hboughardain/automatic-wire-cutter/LaTeX/corps/0-page-de-garde.tex

\center
    \newcommand{\HRule}{\rule{\linewidth}{0.5mm}} 
    
    \begin{figure}
       \centering
      
    \end{figure}
    
    \textsc{\Large Computing project}\\[0.5cm] 
	\textsc{\Large PROJ-H402}\\[0.5cm]

    \vspace{1cm}

	\HRule\\[0.4cm]
	{\huge\bfseries\textsc{Rapport de projet}}\\[0.3cm] 
	\HRule\\[1.5cm]

    \begin{minipage}{0.5\textwidth}
		\begin{flushleft}
			\large
			\textit{Auteur}\\
			Haythem \textsc{Boughardain}
        \end{flushleft}
    \end{minipage}
        ~
	\begin{minipage}{0.4\textwidth}
		\begin{flushright}
			\large
			\textit{Superviseurs}\\
			Quentin \textsc{Delhaye}\\
			François \textsc{Quitin}
		\end{flushright}
	\end{minipage}
        
    \vspace{1cm}
	\begin{figure}[h!]
	   \centering
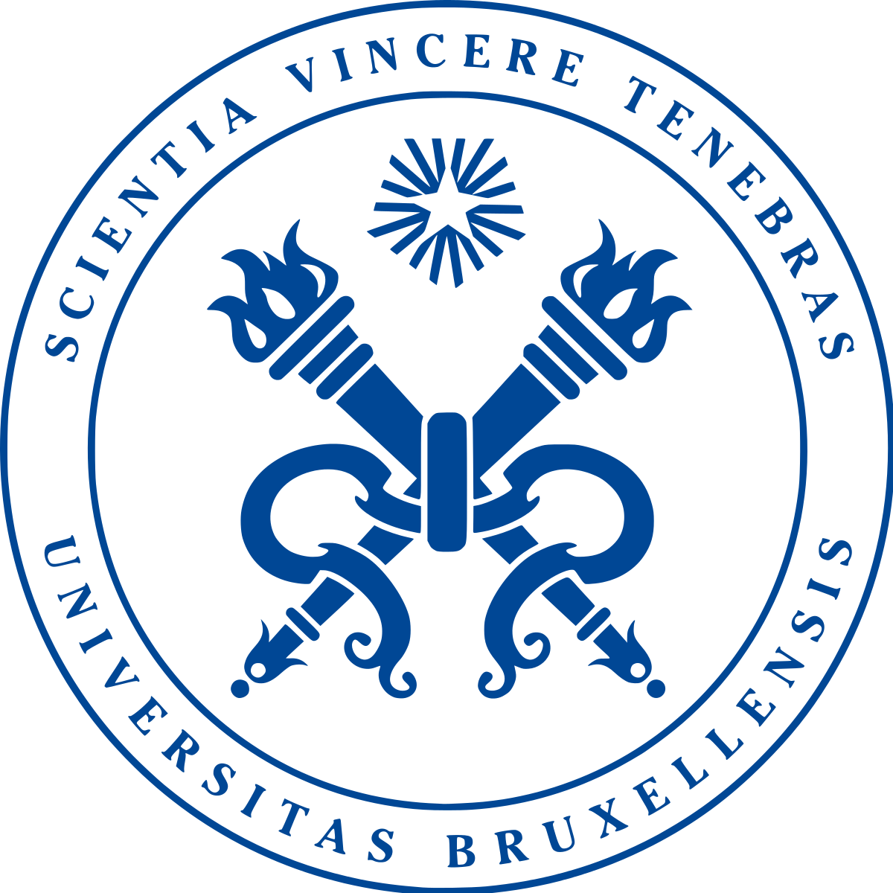
[picture p1: LaTeX/images/logo-ulb.png]
	  
	\end{figure}
    \vspace*{\fill}

	{\large \textsc{Année académique 2021--2022}}
