hboughardain/automatic-wire-cutter/LaTeX/corps/1-intro.tex

Dans le cours de \textsc{Computing project}, il est demandé aux étudiants de choisir un sujet parmi une liste imposée, et de mener à bien le projet qui en découle. Dans le cadre de ce rapport, le projet choisi est celui d'un prototype permettant la coupe automatique de fil électrique, à travers l'utilisation d'un microcontrôleur ainsi que d'un système d'alimentation et de coupe de fil. Ce rapport va ainsi passer sur les choix technologiques qui ont été effectués durant l'année académique, la manière par laquelle le prototype final pourra être dupliqué, comment celui-ci pourra être utilisé, et enfin les améliorations éventuelles qui pourraient lui être apportées.
