hboughardain/automatic-wire-cutter/STL Files/Manivelle.stl

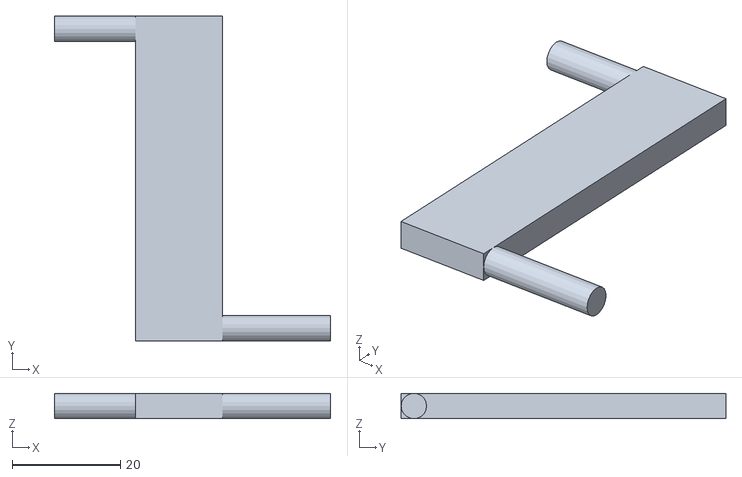
[picture p14: CAD file, 2022-05-17]
STL Files/Manivelle.stl
51.0 x 60.0 x 4.70
