hboughardain/automatic-wire-cutter/STL Files/SupportPince.stl

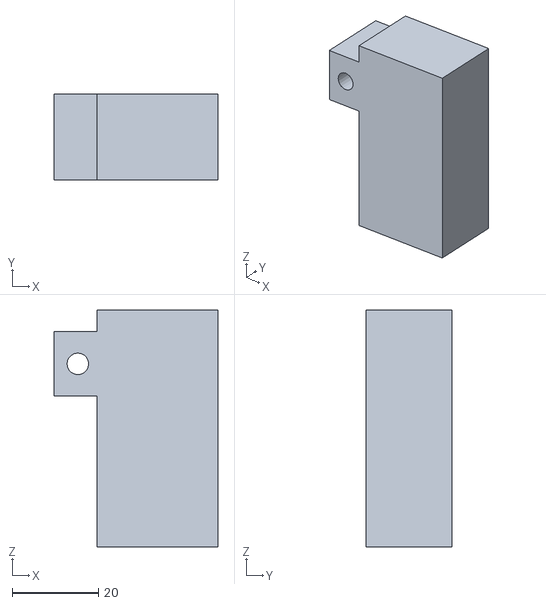
[picture p15: CAD file, 2022-05-17]
STL Files/SupportPince.stl
38.0 x 20.0 x 55.0
