hboughardain/automatic-wire-cutter/STL Files/SupportMoteur.stl

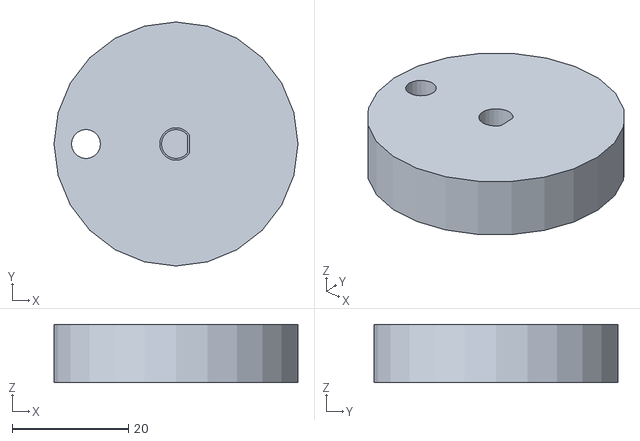
[picture p16: CAD file, 2022-05-17]
STL Files/SupportMoteur.stl
42.0 x 42.0 x 10.0
