hboughardain/automatic-wire-cutter/codegentemp/StepperMotorTimer.h

/*******************************************************************************
* File Name: StepperMotorTimer.h
* Version 2.80
*
*  Description:
*     Contains the function prototypes and constants available to the timer
*     user module.
*
*   Note:
*     None
*
********************************************************************************
* Copyright 2008-2017, Cypress Semiconductor Corporation.  All rights reserved.
* You may use this file only in accordance with the license, terms, conditions,
* disclaimers, and limitations in the end user license agreement accompanying
* the software package with which this file was provided.
********************************************************************************/

#if !defined(CY_TIMER_StepperMotorTimer_H)
#define CY_TIMER_StepperMotorTimer_H

#include "cytypes.h"
#include "cyfitter.h"
#include "CyLib.h" /* For CyEnterCriticalSection() and CyExitCriticalSection() functions */

extern uint8 StepperMotorTimer_initVar;

/* Check to see if required defines such as CY_PSOC5LP are available */
/* They are defined starting with cy_boot v3.0 */
#if !defined (CY_PSOC5LP)
    #error Component Timer_v2_80 requires cy_boot v3.0 or later
#endif /* (CY_ PSOC5LP) */


/**************************************
*           Parameter Defaults
**************************************/

#define StepperMotorTimer_Resolution                 16u
#define StepperMotorTimer_UsingFixedFunction         1u
#define StepperMotorTimer_UsingHWCaptureCounter      0u
#define StepperMotorTimer_SoftwareCaptureMode        0u
#define StepperMotorTimer_SoftwareTriggerMode        0u
#define StepperMotorTimer_UsingHWEnable              0u
#define StepperMotorTimer_EnableTriggerMode          0u
#define StepperMotorTimer_InterruptOnCaptureCount    0u
#define StepperMotorTimer_RunModeUsed                0u
#define StepperMotorTimer_ControlRegRemoved          0u

#if defined(StepperMotorTimer_TimerUDB_sCTRLReg_SyncCtl_ctrlreg__CONTROL_REG)
    #define StepperMotorTimer_UDB_CONTROL_REG_REMOVED            (0u)
#elif  (StepperMotorTimer_UsingFixedFunction)
    #define StepperMotorTimer_UDB_CONTROL_REG_REMOVED            (0u)
#else 
    #define StepperMotorTimer_UDB_CONTROL_REG_REMOVED            (1u)
#endif /* End StepperMotorTimer_TimerUDB_sCTRLReg_SyncCtl_ctrlreg__CONTROL_REG */


/***************************************
*       Type defines
***************************************/


/**************************************************************************
 * Sleep Wakeup Backup structure for Timer Component
 *************************************************************************/
typedef struct
{
    uint8 TimerEnableState;
    #if(!StepperMotorTimer_UsingFixedFunction)

        uint16 TimerUdb;
        uint8 InterruptMaskValue;
        #if (StepperMotorTimer_UsingHWCaptureCounter)
            uint8 TimerCaptureCounter;
        #endif /* variable declarations for backing up non retention registers in CY_UDB_V1 */

        #if (!StepperMotorTimer_UDB_CONTROL_REG_REMOVED)
            uint8 TimerControlRegister;
        #endif /* variable declaration for backing up enable state of the Timer */
    #endif /* define backup variables only for UDB implementation. Fixed function registers are all retention */

}StepperMotorTimer_backupStruct;


/***************************************
*       Function Prototypes
***************************************/

void    StepperMotorTimer_Start(void) ;
void    StepperMotorTimer_Stop(void) ;

void    StepperMotorTimer_SetInterruptMode(uint8 interruptMode) ;
uint8   StepperMotorTimer_ReadStatusRegister(void) ;
/* Deprecated function. Do not use this in future. Retained for backward compatibility */
#define StepperMotorTimer_GetInterruptSource() StepperMotorTimer_ReadStatusRegister()

#if(!StepperMotorTimer_UDB_CONTROL_REG_REMOVED)
    uint8   StepperMotorTimer_ReadControlRegister(void) ;
    void    StepperMotorTimer_WriteControlRegister(uint8 control) ;
#endif /* (!StepperMotorTimer_UDB_CONTROL_REG_REMOVED) */

uint16  StepperMotorTimer_ReadPeriod(void) ;
void    StepperMotorTimer_WritePeriod(uint16 period) ;
uint16  StepperMotorTimer_ReadCounter(void) ;
void    StepperMotorTimer_WriteCounter(uint16 counter) ;
uint16  StepperMotorTimer_ReadCapture(void) ;
void    StepperMotorTimer_SoftwareCapture(void) ;

#if(!StepperMotorTimer_UsingFixedFunction) /* UDB Prototypes */
    #if (StepperMotorTimer_SoftwareCaptureMode)
        void    StepperMotorTimer_SetCaptureMode(uint8 captureMode) ;
    #endif /* (!StepperMotorTimer_UsingFixedFunction) */

    #if (StepperMotorTimer_SoftwareTriggerMode)
        void    StepperMotorTimer_SetTriggerMode(uint8 triggerMode) ;
    #endif /* (StepperMotorTimer_SoftwareTriggerMode) */

    #if (StepperMotorTimer_EnableTriggerMode)
        void    StepperMotorTimer_EnableTrigger(void) ;
        void    StepperMotorTimer_DisableTrigger(void) ;
    #endif /* (StepperMotorTimer_EnableTriggerMode) */


    #if(StepperMotorTimer_InterruptOnCaptureCount)
        void    StepperMotorTimer_SetInterruptCount(uint8 interruptCount) ;
    #endif /* (StepperMotorTimer_InterruptOnCaptureCount) */

    #if (StepperMotorTimer_UsingHWCaptureCounter)
        void    StepperMotorTimer_SetCaptureCount(uint8 captureCount) ;
        uint8   StepperMotorTimer_ReadCaptureCount(void) ;
    #endif /* (StepperMotorTimer_UsingHWCaptureCounter) */

    void StepperMotorTimer_ClearFIFO(void) ;
#endif /* UDB Prototypes */

/* Sleep Retention APIs */
void StepperMotorTimer_Init(void)          ;
void StepperMotorTimer_Enable(void)        ;
void StepperMotorTimer_SaveConfig(void)    ;
void StepperMotorTimer_RestoreConfig(void) ;
void StepperMotorTimer_Sleep(void)         ;
void StepperMotorTimer_Wakeup(void)        ;


/***************************************
*   Enumerated Types and Parameters
***************************************/

/* Enumerated Type B_Timer__CaptureModes, Used in Capture Mode */
#define StepperMotorTimer__B_TIMER__CM_NONE 0
#define StepperMotorTimer__B_TIMER__CM_RISINGEDGE 1
#define StepperMotorTimer__B_TIMER__CM_FALLINGEDGE 2
#define StepperMotorTimer__B_TIMER__CM_EITHEREDGE 3
#define StepperMotorTimer__B_TIMER__CM_SOFTWARE 4



/* Enumerated Type B_Timer__TriggerModes, Used in Trigger Mode */
#define StepperMotorTimer__B_TIMER__TM_NONE 0x00u
#define StepperMotorTimer__B_TIMER__TM_RISINGEDGE 0x04u
#define StepperMotorTimer__B_TIMER__TM_FALLINGEDGE 0x08u
#define StepperMotorTimer__B_TIMER__TM_EITHEREDGE 0x0Cu
#define StepperMotorTimer__B_TIMER__TM_SOFTWARE 0x10u


/***************************************
*    Initialial Parameter Constants
***************************************/

#define StepperMotorTimer_INIT_PERIOD             23999u
#define StepperMotorTimer_INIT_CAPTURE_MODE       ((uint8)((uint8)1u << StepperMotorTimer_CTRL_CAP_MODE_SHIFT))
#define StepperMotorTimer_INIT_TRIGGER_MODE       ((uint8)((uint8)0u << StepperMotorTimer_CTRL_TRIG_MODE_SHIFT))
#if (StepperMotorTimer_UsingFixedFunction)
    #define StepperMotorTimer_INIT_INTERRUPT_MODE (((uint8)((uint8)0u << StepperMotorTimer_STATUS_TC_INT_MASK_SHIFT)) | \
                                                  ((uint8)((uint8)0 << StepperMotorTimer_STATUS_CAPTURE_INT_MASK_SHIFT)))
#else
    #define StepperMotorTimer_INIT_INTERRUPT_MODE (((uint8)((uint8)0u << StepperMotorTimer_STATUS_TC_INT_MASK_SHIFT)) | \
                                                 ((uint8)((uint8)0 << StepperMotorTimer_STATUS_CAPTURE_INT_MASK_SHIFT)) | \
                                                 ((uint8)((uint8)0 << StepperMotorTimer_STATUS_FIFOFULL_INT_MASK_SHIFT)))
#endif /* (StepperMotorTimer_UsingFixedFunction) */
#define StepperMotorTimer_INIT_CAPTURE_COUNT      (2u)
#define StepperMotorTimer_INIT_INT_CAPTURE_COUNT  ((uint8)((uint8)(1u - 1u) << StepperMotorTimer_CTRL_INTCNT_SHIFT))


/***************************************
*           Registers
***************************************/

#if (StepperMotorTimer_UsingFixedFunction) /* Implementation Specific Registers and Register Constants */


    /***************************************
    *    Fixed Function Registers
    ***************************************/

    #define StepperMotorTimer_STATUS         (*(reg8 *) StepperMotorTimer_TimerHW__SR0 )
    /* In Fixed Function Block Status and Mask are the same register */
    #define StepperMotorTimer_STATUS_MASK    (*(reg8 *) StepperMotorTimer_TimerHW__SR0 )
    #define StepperMotorTimer_CONTROL        (*(reg8 *) StepperMotorTimer_TimerHW__CFG0)
    #define StepperMotorTimer_CONTROL2       (*(reg8 *) StepperMotorTimer_TimerHW__CFG1)
    #define StepperMotorTimer_CONTROL2_PTR   ( (reg8 *) StepperMotorTimer_TimerHW__CFG1)
    #define StepperMotorTimer_RT1            (*(reg8 *) StepperMotorTimer_TimerHW__RT1)
    #define StepperMotorTimer_RT1_PTR        ( (reg8 *) StepperMotorTimer_TimerHW__RT1)

    #if (CY_PSOC3 || CY_PSOC5LP)
        #define StepperMotorTimer_CONTROL3       (*(reg8 *) StepperMotorTimer_TimerHW__CFG2)
        #define StepperMotorTimer_CONTROL3_PTR   ( (reg8 *) StepperMotorTimer_TimerHW__CFG2)
    #endif /* (CY_PSOC3 || CY_PSOC5LP) */
    #define StepperMotorTimer_GLOBAL_ENABLE  (*(reg8 *) StepperMotorTimer_TimerHW__PM_ACT_CFG)
    #define StepperMotorTimer_GLOBAL_STBY_ENABLE  (*(reg8 *) StepperMotorTimer_TimerHW__PM_STBY_CFG)

    #define StepperMotorTimer_CAPTURE_LSB         (* (reg16 *) StepperMotorTimer_TimerHW__CAP0 )
    #define StepperMotorTimer_CAPTURE_LSB_PTR       ((reg16 *) StepperMotorTimer_TimerHW__CAP0 )
    #define StepperMotorTimer_PERIOD_LSB          (* (reg16 *) StepperMotorTimer_TimerHW__PER0 )
    #define StepperMotorTimer_PERIOD_LSB_PTR        ((reg16 *) StepperMotorTimer_TimerHW__PER0 )
    #define StepperMotorTimer_COUNTER_LSB         (* (reg16 *) StepperMotorTimer_TimerHW__CNT_CMP0 )
    #define StepperMotorTimer_COUNTER_LSB_PTR       ((reg16 *) StepperMotorTimer_TimerHW__CNT_CMP0 )


    /***************************************
    *    Register Constants
    ***************************************/

    /* Fixed Function Block Chosen */
    #define StepperMotorTimer_BLOCK_EN_MASK                     StepperMotorTimer_TimerHW__PM_ACT_MSK
    #define StepperMotorTimer_BLOCK_STBY_EN_MASK                StepperMotorTimer_TimerHW__PM_STBY_MSK

    /* Control Register Bit Locations */
    /* Interrupt Count - Not valid for Fixed Function Block */
    #define StepperMotorTimer_CTRL_INTCNT_SHIFT                  0x00u
    /* Trigger Polarity - Not valid for Fixed Function Block */
    #define StepperMotorTimer_CTRL_TRIG_MODE_SHIFT               0x00u
    /* Trigger Enable - Not valid for Fixed Function Block */
    #define StepperMotorTimer_CTRL_TRIG_EN_SHIFT                 0x00u
    /* Capture Polarity - Not valid for Fixed Function Block */
    #define StepperMotorTimer_CTRL_CAP_MODE_SHIFT                0x00u
    /* Timer Enable - As defined in Register Map, part of TMRX_CFG0 register */
    #define StepperMotorTimer_CTRL_ENABLE_SHIFT                  0x00u

    /* Control Register Bit Masks */
    #define StepperMotorTimer_CTRL_ENABLE                        ((uint8)((uint8)0x01u << StepperMotorTimer_CTRL_ENABLE_SHIFT))

    /* Control2 Register Bit Masks */
    /* As defined in Register Map, Part of the TMRX_CFG1 register */
    #define StepperMotorTimer_CTRL2_IRQ_SEL_SHIFT                 0x00u
    #define StepperMotorTimer_CTRL2_IRQ_SEL                      ((uint8)((uint8)0x01u << StepperMotorTimer_CTRL2_IRQ_SEL_SHIFT))

    #if (CY_PSOC5A)
        /* Use CFG1 Mode bits to set run mode */
        /* As defined by Verilog Implementation */
        #define StepperMotorTimer_CTRL_MODE_SHIFT                 0x01u
        #define StepperMotorTimer_CTRL_MODE_MASK                 ((uint8)((uint8)0x07u << StepperMotorTimer_CTRL_MODE_SHIFT))
    #endif /* (CY_PSOC5A) */
    #if (CY_PSOC3 || CY_PSOC5LP)
        /* Control3 Register Bit Locations */
        #define StepperMotorTimer_CTRL_RCOD_SHIFT        0x02u
        #define StepperMotorTimer_CTRL_ENBL_SHIFT        0x00u
        #define StepperMotorTimer_CTRL_MODE_SHIFT        0x00u

        /* Control3 Register Bit Masks */
        #define StepperMotorTimer_CTRL_RCOD_MASK  ((uint8)((uint8)0x03u << StepperMotorTimer_CTRL_RCOD_SHIFT)) /* ROD and COD bit masks */
        #define StepperMotorTimer_CTRL_ENBL_MASK  ((uint8)((uint8)0x80u << StepperMotorTimer_CTRL_ENBL_SHIFT)) /* HW_EN bit mask */
        #define StepperMotorTimer_CTRL_MODE_MASK  ((uint8)((uint8)0x03u << StepperMotorTimer_CTRL_MODE_SHIFT)) /* Run mode bit mask */

        #define StepperMotorTimer_CTRL_RCOD       ((uint8)((uint8)0x03u << StepperMotorTimer_CTRL_RCOD_SHIFT))
        #define StepperMotorTimer_CTRL_ENBL       ((uint8)((uint8)0x80u << StepperMotorTimer_CTRL_ENBL_SHIFT))
    #endif /* (CY_PSOC3 || CY_PSOC5LP) */

    /*RT1 Synch Constants: Applicable for PSoC3 and PSoC5LP */
    #define StepperMotorTimer_RT1_SHIFT                       0x04u
    /* Sync TC and CMP bit masks */
    #define StepperMotorTimer_RT1_MASK                        ((uint8)((uint8)0x03u << StepperMotorTimer_RT1_SHIFT))
    #define StepperMotorTimer_SYNC                            ((uint8)((uint8)0x03u << StepperMotorTimer_RT1_SHIFT))
    #define StepperMotorTimer_SYNCDSI_SHIFT                   0x00u
    /* Sync all DSI inputs with Mask  */
    #define StepperMotorTimer_SYNCDSI_MASK                    ((uint8)((uint8)0x0Fu << StepperMotorTimer_SYNCDSI_SHIFT))
    /* Sync all DSI inputs */
    #define StepperMotorTimer_SYNCDSI_EN                      ((uint8)((uint8)0x0Fu << StepperMotorTimer_SYNCDSI_SHIFT))

    #define StepperMotorTimer_CTRL_MODE_PULSEWIDTH            ((uint8)((uint8)0x01u << StepperMotorTimer_CTRL_MODE_SHIFT))
    #define StepperMotorTimer_CTRL_MODE_PERIOD                ((uint8)((uint8)0x02u << StepperMotorTimer_CTRL_MODE_SHIFT))
    #define StepperMotorTimer_CTRL_MODE_CONTINUOUS            ((uint8)((uint8)0x00u << StepperMotorTimer_CTRL_MODE_SHIFT))

    /* Status Register Bit Locations */
    /* As defined in Register Map, part of TMRX_SR0 register */
    #define StepperMotorTimer_STATUS_TC_SHIFT                 0x07u
    /* As defined in Register Map, part of TMRX_SR0 register, Shared with Compare Status */
    #define StepperMotorTimer_STATUS_CAPTURE_SHIFT            0x06u
    /* As defined in Register Map, part of TMRX_SR0 register */
    #define StepperMotorTimer_STATUS_TC_INT_MASK_SHIFT        (StepperMotorTimer_STATUS_TC_SHIFT - 0x04u)
    /* As defined in Register Map, part of TMRX_SR0 register, Shared with Compare Status */
    #define StepperMotorTimer_STATUS_CAPTURE_INT_MASK_SHIFT   (StepperMotorTimer_STATUS_CAPTURE_SHIFT - 0x04u)

    /* Status Register Bit Masks */
    #define StepperMotorTimer_STATUS_TC                       ((uint8)((uint8)0x01u << StepperMotorTimer_STATUS_TC_SHIFT))
    #define StepperMotorTimer_STATUS_CAPTURE                  ((uint8)((uint8)0x01u << StepperMotorTimer_STATUS_CAPTURE_SHIFT))
    /* Interrupt Enable Bit-Mask for interrupt on TC */
    #define StepperMotorTimer_STATUS_TC_INT_MASK              ((uint8)((uint8)0x01u << StepperMotorTimer_STATUS_TC_INT_MASK_SHIFT))
    /* Interrupt Enable Bit-Mask for interrupt on Capture */
    #define StepperMotorTimer_STATUS_CAPTURE_INT_MASK         ((uint8)((uint8)0x01u << StepperMotorTimer_STATUS_CAPTURE_INT_MASK_SHIFT))

#else   /* UDB Registers and Register Constants */


    /***************************************
    *           UDB Registers
    ***************************************/

    #define StepperMotorTimer_STATUS              (* (reg8 *) StepperMotorTimer_TimerUDB_rstSts_stsreg__STATUS_REG )
    #define StepperMotorTimer_STATUS_MASK         (* (reg8 *) StepperMotorTimer_TimerUDB_rstSts_stsreg__MASK_REG)
    #define StepperMotorTimer_STATUS_AUX_CTRL     (* (reg8 *) StepperMotorTimer_TimerUDB_rstSts_stsreg__STATUS_AUX_CTL_REG)
    #define StepperMotorTimer_CONTROL             (* (reg8 *) StepperMotorTimer_TimerUDB_sCTRLReg_SyncCtl_ctrlreg__CONTROL_REG )
    
    #if(StepperMotorTimer_Resolution <= 8u) /* 8-bit Timer */
        #define StepperMotorTimer_CAPTURE_LSB         (* (reg8 *) StepperMotorTimer_TimerUDB_sT16_timerdp_u0__F0_REG )
        #define StepperMotorTimer_CAPTURE_LSB_PTR       ((reg8 *) StepperMotorTimer_TimerUDB_sT16_timerdp_u0__F0_REG )
        #define StepperMotorTimer_PERIOD_LSB          (* (reg8 *) StepperMotorTimer_TimerUDB_sT16_timerdp_u0__D0_REG )
        #define StepperMotorTimer_PERIOD_LSB_PTR        ((reg8 *) StepperMotorTimer_TimerUDB_sT16_timerdp_u0__D0_REG )
        #define StepperMotorTimer_COUNTER_LSB         (* (reg8 *) StepperMotorTimer_TimerUDB_sT16_timerdp_u0__A0_REG )
        #define StepperMotorTimer_COUNTER_LSB_PTR       ((reg8 *) StepperMotorTimer_TimerUDB_sT16_timerdp_u0__A0_REG )
    #elif(StepperMotorTimer_Resolution <= 16u) /* 8-bit Timer */
        #if(CY_PSOC3) /* 8-bit addres space */
            #define StepperMotorTimer_CAPTURE_LSB         (* (reg16 *) StepperMotorTimer_TimerUDB_sT16_timerdp_u0__F0_REG )
            #define StepperMotorTimer_CAPTURE_LSB_PTR       ((reg16 *) StepperMotorTimer_TimerUDB_sT16_timerdp_u0__F0_REG )
            #define StepperMotorTimer_PERIOD_LSB          (* (reg16 *) StepperMotorTimer_TimerUDB_sT16_timerdp_u0__D0_REG )
            #define StepperMotorTimer_PERIOD_LSB_PTR        ((reg16 *) StepperMotorTimer_TimerUDB_sT16_timerdp_u0__D0_REG )
            #define StepperMotorTimer_COUNTER_LSB         (* (reg16 *) StepperMotorTimer_TimerUDB_sT16_timerdp_u0__A0_REG )
            #define StepperMotorTimer_COUNTER_LSB_PTR       ((reg16 *) StepperMotorTimer_TimerUDB_sT16_timerdp_u0__A0_REG )
        #else /* 16-bit address space */
            #define StepperMotorTimer_CAPTURE_LSB         (* (reg16 *) StepperMotorTimer_TimerUDB_sT16_timerdp_u0__16BIT_F0_REG )
            #define StepperMotorTimer_CAPTURE_LSB_PTR       ((reg16 *) StepperMotorTimer_TimerUDB_sT16_timerdp_u0__16BIT_F0_REG )
            #define StepperMotorTimer_PERIOD_LSB          (* (reg16 *) StepperMotorTimer_TimerUDB_sT16_timerdp_u0__16BIT_D0_REG )
            #define StepperMotorTimer_PERIOD_LSB_PTR        ((reg16 *) StepperMotorTimer_TimerUDB_sT16_timerdp_u0__16BIT_D0_REG )
            #define StepperMotorTimer_COUNTER_LSB         (* (reg16 *) StepperMotorTimer_TimerUDB_sT16_timerdp_u0__16BIT_A0_REG )
            #define StepperMotorTimer_COUNTER_LSB_PTR       ((reg16 *) StepperMotorTimer_TimerUDB_sT16_timerdp_u0__16BIT_A0_REG )
        #endif /* CY_PSOC3 */
    #elif(StepperMotorTimer_Resolution <= 24u)/* 24-bit Timer */
        #define StepperMotorTimer_CAPTURE_LSB         (* (reg32 *) StepperMotorTimer_TimerUDB_sT16_timerdp_u0__F0_REG )
        #define StepperMotorTimer_CAPTURE_LSB_PTR       ((reg32 *) StepperMotorTimer_TimerUDB_sT16_timerdp_u0__F0_REG )
        #define StepperMotorTimer_PERIOD_LSB          (* (reg32 *) StepperMotorTimer_TimerUDB_sT16_timerdp_u0__D0_REG )
        #define StepperMotorTimer_PERIOD_LSB_PTR        ((reg32 *) StepperMotorTimer_TimerUDB_sT16_timerdp_u0__D0_REG )
        #define StepperMotorTimer_COUNTER_LSB         (* (reg32 *) StepperMotorTimer_TimerUDB_sT16_timerdp_u0__A0_REG )
        #define StepperMotorTimer_COUNTER_LSB_PTR       ((reg32 *) StepperMotorTimer_TimerUDB_sT16_timerdp_u0__A0_REG )
    #else /* 32-bit Timer */
        #if(CY_PSOC3 || CY_PSOC5) /* 8-bit address space */
            #define StepperMotorTimer_CAPTURE_LSB         (* (reg32 *) StepperMotorTimer_TimerUDB_sT16_timerdp_u0__F0_REG )
            #define StepperMotorTimer_CAPTURE_LSB_PTR       ((reg32 *) StepperMotorTimer_TimerUDB_sT16_timerdp_u0__F0_REG )
            #define StepperMotorTimer_PERIOD_LSB          (* (reg32 *) StepperMotorTimer_TimerUDB_sT16_timerdp_u0__D0_REG )
            #define StepperMotorTimer_PERIOD_LSB_PTR        ((reg32 *) StepperMotorTimer_TimerUDB_sT16_timerdp_u0__D0_REG )
            #define StepperMotorTimer_COUNTER_LSB         (* (reg32 *) StepperMotorTimer_TimerUDB_sT16_timerdp_u0__A0_REG )
            #define StepperMotorTimer_COUNTER_LSB_PTR       ((reg32 *) StepperMotorTimer_TimerUDB_sT16_timerdp_u0__A0_REG )
        #else /* 32-bit address space */
            #define StepperMotorTimer_CAPTURE_LSB         (* (reg32 *) StepperMotorTimer_TimerUDB_sT16_timerdp_u0__32BIT_F0_REG )
            #define StepperMotorTimer_CAPTURE_LSB_PTR       ((reg32 *) StepperMotorTimer_TimerUDB_sT16_timerdp_u0__32BIT_F0_REG )
            #define StepperMotorTimer_PERIOD_LSB          (* (reg32 *) StepperMotorTimer_TimerUDB_sT16_timerdp_u0__32BIT_D0_REG )
            #define StepperMotorTimer_PERIOD_LSB_PTR        ((reg32 *) StepperMotorTimer_TimerUDB_sT16_timerdp_u0__32BIT_D0_REG )
            #define StepperMotorTimer_COUNTER_LSB         (* (reg32 *) StepperMotorTimer_TimerUDB_sT16_timerdp_u0__32BIT_A0_REG )
            #define StepperMotorTimer_COUNTER_LSB_PTR       ((reg32 *) StepperMotorTimer_TimerUDB_sT16_timerdp_u0__32BIT_A0_REG )
        #endif /* CY_PSOC3 || CY_PSOC5 */ 
    #endif

    #define StepperMotorTimer_COUNTER_LSB_PTR_8BIT       ((reg8 *) StepperMotorTimer_TimerUDB_sT16_timerdp_u0__A0_REG )
    
    #if (StepperMotorTimer_UsingHWCaptureCounter)
        #define StepperMotorTimer_CAP_COUNT              (*(reg8 *) StepperMotorTimer_TimerUDB_sCapCount_counter__PERIOD_REG )
        #define StepperMotorTimer_CAP_COUNT_PTR          ( (reg8 *) StepperMotorTimer_TimerUDB_sCapCount_counter__PERIOD_REG )
        #define StepperMotorTimer_CAPTURE_COUNT_CTRL     (*(reg8 *) StepperMotorTimer_TimerUDB_sCapCount_counter__CONTROL_AUX_CTL_REG )
        #define StepperMotorTimer_CAPTURE_COUNT_CTRL_PTR ( (reg8 *) StepperMotorTimer_TimerUDB_sCapCount_counter__CONTROL_AUX_CTL_REG )
    #endif /* (StepperMotorTimer_UsingHWCaptureCounter) */


    /***************************************
    *       Register Constants
    ***************************************/

    /* Control Register Bit Locations */
    #define StepperMotorTimer_CTRL_INTCNT_SHIFT              0x00u       /* As defined by Verilog Implementation */
    #define StepperMotorTimer_CTRL_TRIG_MODE_SHIFT           0x02u       /* As defined by Verilog Implementation */
    #define StepperMotorTimer_CTRL_TRIG_EN_SHIFT             0x04u       /* As defined by Verilog Implementation */
    #define StepperMotorTimer_CTRL_CAP_MODE_SHIFT            0x05u       /* As defined by Verilog Implementation */
    #define StepperMotorTimer_CTRL_ENABLE_SHIFT              0x07u       /* As defined by Verilog Implementation */

    /* Control Register Bit Masks */
    #define StepperMotorTimer_CTRL_INTCNT_MASK               ((uint8)((uint8)0x03u << StepperMotorTimer_CTRL_INTCNT_SHIFT))
    #define StepperMotorTimer_CTRL_TRIG_MODE_MASK            ((uint8)((uint8)0x03u << StepperMotorTimer_CTRL_TRIG_MODE_SHIFT))
    #define StepperMotorTimer_CTRL_TRIG_EN                   ((uint8)((uint8)0x01u << StepperMotorTimer_CTRL_TRIG_EN_SHIFT))
    #define StepperMotorTimer_CTRL_CAP_MODE_MASK             ((uint8)((uint8)0x03u << StepperMotorTimer_CTRL_CAP_MODE_SHIFT))
    #define StepperMotorTimer_CTRL_ENABLE                    ((uint8)((uint8)0x01u << StepperMotorTimer_CTRL_ENABLE_SHIFT))

    /* Bit Counter (7-bit) Control Register Bit Definitions */
    /* As defined by the Register map for the AUX Control Register */
    #define StepperMotorTimer_CNTR_ENABLE                    0x20u

    /* Status Register Bit Locations */
    #define StepperMotorTimer_STATUS_TC_SHIFT                0x00u  /* As defined by Verilog Implementation */
    #define StepperMotorTimer_STATUS_CAPTURE_SHIFT           0x01u  /* As defined by Verilog Implementation */
    #define StepperMotorTimer_STATUS_TC_INT_MASK_SHIFT       StepperMotorTimer_STATUS_TC_SHIFT
    #define StepperMotorTimer_STATUS_CAPTURE_INT_MASK_SHIFT  StepperMotorTimer_STATUS_CAPTURE_SHIFT
    #define StepperMotorTimer_STATUS_FIFOFULL_SHIFT          0x02u  /* As defined by Verilog Implementation */
    #define StepperMotorTimer_STATUS_FIFONEMP_SHIFT          0x03u  /* As defined by Verilog Implementation */
    #define StepperMotorTimer_STATUS_FIFOFULL_INT_MASK_SHIFT StepperMotorTimer_STATUS_FIFOFULL_SHIFT

    /* Status Register Bit Masks */
    /* Sticky TC Event Bit-Mask */
    #define StepperMotorTimer_STATUS_TC                      ((uint8)((uint8)0x01u << StepperMotorTimer_STATUS_TC_SHIFT))
    /* Sticky Capture Event Bit-Mask */
    #define StepperMotorTimer_STATUS_CAPTURE                 ((uint8)((uint8)0x01u << StepperMotorTimer_STATUS_CAPTURE_SHIFT))
    /* Interrupt Enable Bit-Mask */
    #define StepperMotorTimer_STATUS_TC_INT_MASK             ((uint8)((uint8)0x01u << StepperMotorTimer_STATUS_TC_SHIFT))
    /* Interrupt Enable Bit-Mask */
    #define StepperMotorTimer_STATUS_CAPTURE_INT_MASK        ((uint8)((uint8)0x01u << StepperMotorTimer_STATUS_CAPTURE_SHIFT))
    /* NOT-Sticky FIFO Full Bit-Mask */
    #define StepperMotorTimer_STATUS_FIFOFULL                ((uint8)((uint8)0x01u << StepperMotorTimer_STATUS_FIFOFULL_SHIFT))
    /* NOT-Sticky FIFO Not Empty Bit-Mask */
    #define StepperMotorTimer_STATUS_FIFONEMP                ((uint8)((uint8)0x01u << StepperMotorTimer_STATUS_FIFONEMP_SHIFT))
    /* Interrupt Enable Bit-Mask */
    #define StepperMotorTimer_STATUS_FIFOFULL_INT_MASK       ((uint8)((uint8)0x01u << StepperMotorTimer_STATUS_FIFOFULL_SHIFT))

    #define StepperMotorTimer_STATUS_ACTL_INT_EN             0x10u   /* As defined for the ACTL Register */

    /* Datapath Auxillary Control Register definitions */
    #define StepperMotorTimer_AUX_CTRL_FIFO0_CLR             0x01u   /* As defined by Register map */
    #define StepperMotorTimer_AUX_CTRL_FIFO1_CLR             0x02u   /* As defined by Register map */
    #define StepperMotorTimer_AUX_CTRL_FIFO0_LVL             0x04u   /* As defined by Register map */
    #define StepperMotorTimer_AUX_CTRL_FIFO1_LVL             0x08u   /* As defined by Register map */
    #define StepperMotorTimer_STATUS_ACTL_INT_EN_MASK        0x10u   /* As defined for the ACTL Register */

#endif /* Implementation Specific Registers and Register Constants */

#endif  /* CY_TIMER_StepperMotorTimer_H */


/* [] END OF FILE */
