hboughardain/automatic-wire-cutter/codegentemp/StepperMotorTimer_PM.c

/*******************************************************************************
* File Name: StepperMotorTimer_PM.c
* Version 2.80
*
*  Description:
*     This file provides the power management source code to API for the
*     Timer.
*
*   Note:
*     None
*
*******************************************************************************
* Copyright 2008-2017, Cypress Semiconductor Corporation.  All rights reserved.
* You may use this file only in accordance with the license, terms, conditions,
* disclaimers, and limitations in the end user license agreement accompanying
* the software package with which this file was provided.
********************************************************************************/

#include "StepperMotorTimer.h"

static StepperMotorTimer_backupStruct StepperMotorTimer_backup;


/*******************************************************************************
* Function Name: StepperMotorTimer_SaveConfig
********************************************************************************
*
* Summary:
*     Save the current user configuration
*
* Parameters:
*  void
*
* Return:
*  void
*
* Global variables:
*  StepperMotorTimer_backup:  Variables of this global structure are modified to
*  store the values of non retention configuration registers when Sleep() API is
*  called.
*
*******************************************************************************/
void StepperMotorTimer_SaveConfig(void) 
{
    #if (!StepperMotorTimer_UsingFixedFunction)
        StepperMotorTimer_backup.TimerUdb = StepperMotorTimer_ReadCounter();
        StepperMotorTimer_backup.InterruptMaskValue = StepperMotorTimer_STATUS_MASK;
        #if (StepperMotorTimer_UsingHWCaptureCounter)
            StepperMotorTimer_backup.TimerCaptureCounter = StepperMotorTimer_ReadCaptureCount();
        #endif /* Back Up capture counter register  */

        #if(!StepperMotorTimer_UDB_CONTROL_REG_REMOVED)
            StepperMotorTimer_backup.TimerControlRegister = StepperMotorTimer_ReadControlRegister();
        #endif /* Backup the enable state of the Timer component */
    #endif /* Backup non retention registers in UDB implementation. All fixed function registers are retention */
}


/*******************************************************************************
* Function Name: StepperMotorTimer_RestoreConfig
********************************************************************************
*
* Summary:
*  Restores the current user configuration.
*
* Parameters:
*  void
*
* Return:
*  void
*
* Global variables:
*  StepperMotorTimer_backup:  Variables of this global structure are used to
*  restore the values of non retention registers on wakeup from sleep mode.
*
*******************************************************************************/
void StepperMotorTimer_RestoreConfig(void) 
{   
    #if (!StepperMotorTimer_UsingFixedFunction)

        StepperMotorTimer_WriteCounter(StepperMotorTimer_backup.TimerUdb);
        StepperMotorTimer_STATUS_MASK =StepperMotorTimer_backup.InterruptMaskValue;
        #if (StepperMotorTimer_UsingHWCaptureCounter)
            StepperMotorTimer_SetCaptureCount(StepperMotorTimer_backup.TimerCaptureCounter);
        #endif /* Restore Capture counter register*/

        #if(!StepperMotorTimer_UDB_CONTROL_REG_REMOVED)
            StepperMotorTimer_WriteControlRegister(StepperMotorTimer_backup.TimerControlRegister);
        #endif /* Restore the enable state of the Timer component */
    #endif /* Restore non retention registers in the UDB implementation only */
}


/*******************************************************************************
* Function Name: StepperMotorTimer_Sleep
********************************************************************************
*
* Summary:
*     Stop and Save the user configuration
*
* Parameters:
*  void
*
* Return:
*  void
*
* Global variables:
*  StepperMotorTimer_backup.TimerEnableState:  Is modified depending on the
*  enable state of the block before entering sleep mode.
*
*******************************************************************************/
void StepperMotorTimer_Sleep(void) 
{
    #if(!StepperMotorTimer_UDB_CONTROL_REG_REMOVED)
        /* Save Counter's enable state */
        if(StepperMotorTimer_CTRL_ENABLE == (StepperMotorTimer_CONTROL & StepperMotorTimer_CTRL_ENABLE))
        {
            /* Timer is enabled */
            StepperMotorTimer_backup.TimerEnableState = 1u;
        }
        else
        {
            /* Timer is disabled */
            StepperMotorTimer_backup.TimerEnableState = 0u;
        }
    #endif /* Back up enable state from the Timer control register */
    StepperMotorTimer_Stop();
    StepperMotorTimer_SaveConfig();
}


/*******************************************************************************
* Function Name: StepperMotorTimer_Wakeup
********************************************************************************
*
* Summary:
*  Restores and enables the user configuration
*
* Parameters:
*  void
*
* Return:
*  void
*
* Global variables:
*  StepperMotorTimer_backup.enableState:  Is used to restore the enable state of
*  block on wakeup from sleep mode.
*
*******************************************************************************/
void StepperMotorTimer_Wakeup(void) 
{
    StepperMotorTimer_RestoreConfig();
    #if(!StepperMotorTimer_UDB_CONTROL_REG_REMOVED)
        if(StepperMotorTimer_backup.TimerEnableState == 1u)
        {     /* Enable Timer's operation */
                StepperMotorTimer_Enable();
        } /* Do nothing if Timer was disabled before */
    #endif /* Remove this code section if Control register is removed */
}


/* [] END OF FILE */
