hboughardain/automatic-wire-cutter/codegentemp/Servomotor_aliases.h

/*******************************************************************************
* File Name: Servomotor.h  
* Version 2.20
*
* Description:
*  This file contains the Alias definitions for Per-Pin APIs in cypins.h. 
*  Information on using these APIs can be found in the System Reference Guide.
*
* Note:
*
********************************************************************************
* Copyright 2008-2015, Cypress Semiconductor Corporation.  All rights reserved.
* You may use this file only in accordance with the license, terms, conditions, 
* disclaimers, and limitations in the end user license agreement accompanying 
* the software package with which this file was provided.
*******************************************************************************/

#if !defined(CY_PINS_Servomotor_ALIASES_H) /* Pins Servomotor_ALIASES_H */
#define CY_PINS_Servomotor_ALIASES_H

#include "cytypes.h"
#include "cyfitter.h"


/***************************************
*              Constants        
***************************************/
#define Servomotor_0			(Servomotor__0__PC)
#define Servomotor_0_INTR	((uint16)((uint16)0x0001u << Servomotor__0__SHIFT))

#define Servomotor_INTR_ALL	 ((uint16)(Servomotor_0_INTR))

#endif /* End Pins Servomotor_ALIASES_H */


/* [] END OF FILE */
