hboughardain/automatic-wire-cutter/codegentemp/SW4.h

/*******************************************************************************
* File Name: SW4.h  
* Version 2.20
*
* Description:
*  This file contains Pin function prototypes and register defines
*
* Note:
*
********************************************************************************
* Copyright 2008-2015, Cypress Semiconductor Corporation.  All rights reserved.
* You may use this file only in accordance with the license, terms, conditions, 
* disclaimers, and limitations in the end user license agreement accompanying 
* the software package with which this file was provided.
*******************************************************************************/

#if !defined(CY_PINS_SW4_H) /* Pins SW4_H */
#define CY_PINS_SW4_H

#include "cytypes.h"
#include "cyfitter.h"
#include "cypins.h"
#include "SW4_aliases.h"

/* APIs are not generated for P15[7:6] */
#if !(CY_PSOC5A &&\
	 SW4__PORT == 15 && ((SW4__MASK & 0xC0) != 0))


/***************************************
*        Function Prototypes             
***************************************/    

/**
* \addtogroup group_general
* @{
*/
void    SW4_Write(uint8 value);
void    SW4_SetDriveMode(uint8 mode);
uint8   SW4_ReadDataReg(void);
uint8   SW4_Read(void);
void    SW4_SetInterruptMode(uint16 position, uint16 mode);
uint8   SW4_ClearInterrupt(void);
/** @} general */

/***************************************
*           API Constants        
***************************************/
/**
* \addtogroup group_constants
* @{
*/
    /** \addtogroup driveMode Drive mode constants
     * \brief Constants to be passed as "mode" parameter in the SW4_SetDriveMode() function.
     *  @{
     */
        #define SW4_DM_ALG_HIZ         PIN_DM_ALG_HIZ
        #define SW4_DM_DIG_HIZ         PIN_DM_DIG_HIZ
        #define SW4_DM_RES_UP          PIN_DM_RES_UP
        #define SW4_DM_RES_DWN         PIN_DM_RES_DWN
        #define SW4_DM_OD_LO           PIN_DM_OD_LO
        #define SW4_DM_OD_HI           PIN_DM_OD_HI
        #define SW4_DM_STRONG          PIN_DM_STRONG
        #define SW4_DM_RES_UPDWN       PIN_DM_RES_UPDWN
    /** @} driveMode */
/** @} group_constants */
    
/* Digital Port Constants */
#define SW4_MASK               SW4__MASK
#define SW4_SHIFT              SW4__SHIFT
#define SW4_WIDTH              1u

/* Interrupt constants */
#if defined(SW4__INTSTAT)
/**
* \addtogroup group_constants
* @{
*/
    /** \addtogroup intrMode Interrupt constants
     * \brief Constants to be passed as "mode" parameter in SW4_SetInterruptMode() function.
     *  @{
     */
        #define SW4_INTR_NONE      (uint16)(0x0000u)
        #define SW4_INTR_RISING    (uint16)(0x0001u)
        #define SW4_INTR_FALLING   (uint16)(0x0002u)
        #define SW4_INTR_BOTH      (uint16)(0x0003u) 
    /** @} intrMode */
/** @} group_constants */

    #define SW4_INTR_MASK      (0x01u) 
#endif /* (SW4__INTSTAT) */


/***************************************
*             Registers        
***************************************/

/* Main Port Registers */
/* Pin State */
#define SW4_PS                     (* (reg8 *) SW4__PS)
/* Data Register */
#define SW4_DR                     (* (reg8 *) SW4__DR)
/* Port Number */
#define SW4_PRT_NUM                (* (reg8 *) SW4__PRT) 
/* Connect to Analog Globals */                                                  
#define SW4_AG                     (* (reg8 *) SW4__AG)                       
/* Analog MUX bux enable */
#define SW4_AMUX                   (* (reg8 *) SW4__AMUX) 
/* Bidirectional Enable */                                                        
#define SW4_BIE                    (* (reg8 *) SW4__BIE)
/* Bit-mask for Aliased Register Access */
#define SW4_BIT_MASK               (* (reg8 *) SW4__BIT_MASK)
/* Bypass Enable */
#define SW4_BYP                    (* (reg8 *) SW4__BYP)
/* Port wide control signals */                                                   
#define SW4_CTL                    (* (reg8 *) SW4__CTL)
/* Drive Modes */
#define SW4_DM0                    (* (reg8 *) SW4__DM0) 
#define SW4_DM1                    (* (reg8 *) SW4__DM1)
#define SW4_DM2                    (* (reg8 *) SW4__DM2) 
/* Input Buffer Disable Override */
#define SW4_INP_DIS                (* (reg8 *) SW4__INP_DIS)
/* LCD Common or Segment Drive */
#define SW4_LCD_COM_SEG            (* (reg8 *) SW4__LCD_COM_SEG)
/* Enable Segment LCD */
#define SW4_LCD_EN                 (* (reg8 *) SW4__LCD_EN)
/* Slew Rate Control */
#define SW4_SLW                    (* (reg8 *) SW4__SLW)

/* DSI Port Registers */
/* Global DSI Select Register */
#define SW4_PRTDSI__CAPS_SEL       (* (reg8 *) SW4__PRTDSI__CAPS_SEL) 
/* Double Sync Enable */
#define SW4_PRTDSI__DBL_SYNC_IN    (* (reg8 *) SW4__PRTDSI__DBL_SYNC_IN) 
/* Output Enable Select Drive Strength */
#define SW4_PRTDSI__OE_SEL0        (* (reg8 *) SW4__PRTDSI__OE_SEL0) 
#define SW4_PRTDSI__OE_SEL1        (* (reg8 *) SW4__PRTDSI__OE_SEL1) 
/* Port Pin Output Select Registers */
#define SW4_PRTDSI__OUT_SEL0       (* (reg8 *) SW4__PRTDSI__OUT_SEL0) 
#define SW4_PRTDSI__OUT_SEL1       (* (reg8 *) SW4__PRTDSI__OUT_SEL1) 
/* Sync Output Enable Registers */
#define SW4_PRTDSI__SYNC_OUT       (* (reg8 *) SW4__PRTDSI__SYNC_OUT) 

/* SIO registers */
#if defined(SW4__SIO_CFG)
    #define SW4_SIO_HYST_EN        (* (reg8 *) SW4__SIO_HYST_EN)
    #define SW4_SIO_REG_HIFREQ     (* (reg8 *) SW4__SIO_REG_HIFREQ)
    #define SW4_SIO_CFG            (* (reg8 *) SW4__SIO_CFG)
    #define SW4_SIO_DIFF           (* (reg8 *) SW4__SIO_DIFF)
#endif /* (SW4__SIO_CFG) */

/* Interrupt Registers */
#if defined(SW4__INTSTAT)
    #define SW4_INTSTAT            (* (reg8 *) SW4__INTSTAT)
    #define SW4_SNAP               (* (reg8 *) SW4__SNAP)
    
	#define SW4_0_INTTYPE_REG 		(* (reg8 *) SW4__0__INTTYPE)
#endif /* (SW4__INTSTAT) */

#endif /* CY_PSOC5A... */

#endif /*  CY_PINS_SW4_H */


/* [] END OF FILE */
