hboughardain/automatic-wire-cutter/(commit log)

2021-11-16 Coding and cleanup of stepper motor functions
    [PROJ-H402.sdf]
2022-03-11 Servomotor functionality added
    [PROJ-H402.sdf]
2022-05-09 Final version code
    [PROJ-H402.sdf]
2022-05-17 Final commit
    [Manivelle.stl, SupportMoteur.stl, SupportPince.stl]
